lihuan23733683/NetworkRadio/src/audio/Tone.h

// ============================================================================
//  Tone.h  --  硬件自检测试音
//  绕开音频库，直接用 I2S_NUM_1 推一段正弦波到 MAX98357A，
//  用来判断"功放 + 喇叭 + 接线"是否正常（与网络、解码、音频库全部无关）。
//  注意：测试结束后本端口占用的 GPIO 会失效，必须重启才能恢复收音。
// ============================================================================
#pragma once
#include <Arduino.h>

// freq: 频率 Hz；ms: 时长；ampPct: 振幅百分比 1~100
// 返回 false 表示 I2S 测试通道创建失败
bool tonePlay(uint32_t freq, uint32_t ms, uint8_t ampPct);
