lihuan23733683/NetworkRadio/(commit log)

2026-11-09 NetworkRadio v0.7.5：ESP32-S3 网络收音机（彩屏+旋钮+网页控制台）
2026-11-09 docs: 增加固件下载与一键烧录说明，新增发布脚本 tools/publish_release.py
2026-11-10 feat: 顶栏右侧改为 WiFi 信号强度实时显示 (v0.7.6)
2026-11-10 feat: WiFi 信号改为手机样式图标（点+三层弧，随强度点亮）v0.7.7
2026-11-10 feat: WiFi 图标改为细线条样式（手机经典 WiFi 图标）v0.7.8
